jajmangold/emt-corexy/stl/TeeZCross_M.stl

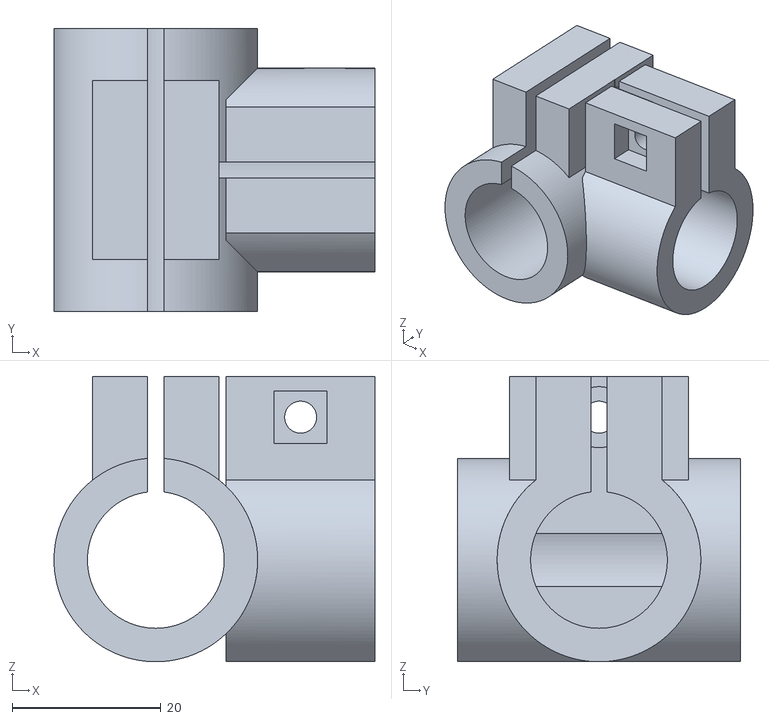
[picture p4: CAD file, 2026-11-10]
stl/TeeZCross_M.stl
43.2 x 38.0 x 38.4
