jajmangold/emt-corexy/stl/BedCarriage.stl

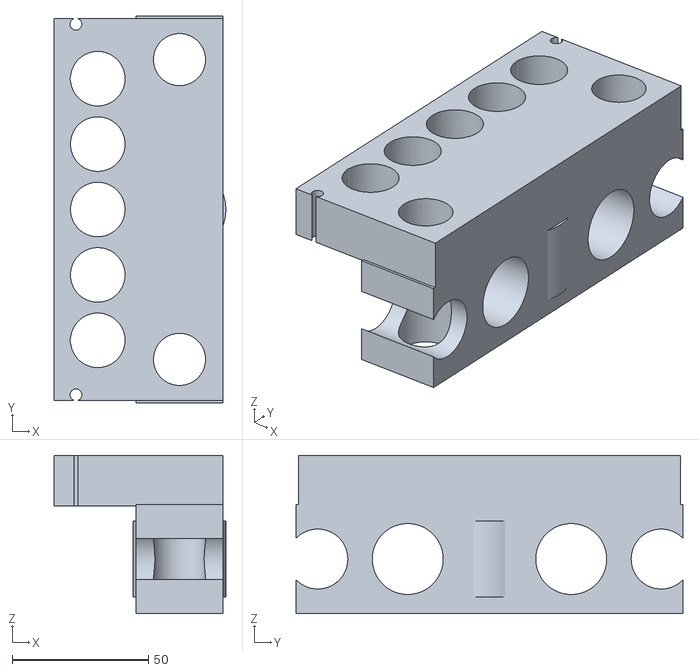
[picture p5: CAD file, 2026-11-10]
stl/BedCarriage.stl
63.0 x 142.0 x 58.0
