jajmangold/emt-corexy/stl/ZMotorMount_M.stl

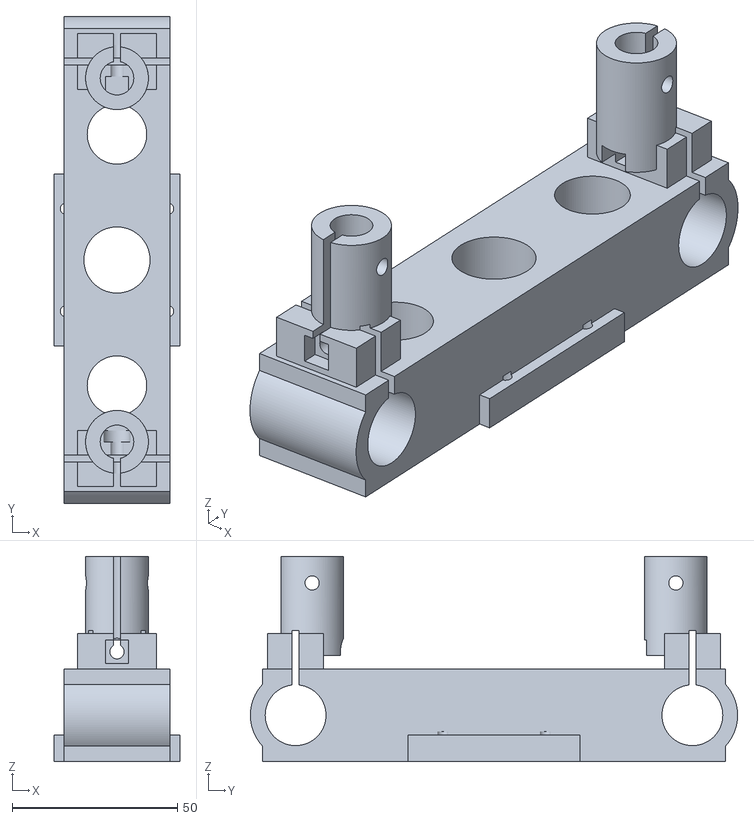
[picture p6: CAD file, 2026-11-10]
stl/ZMotorMount_M.stl
38.0 x 147.4 x 62.0
