jajmangold/emt-corexy/stl/BedMount.stl

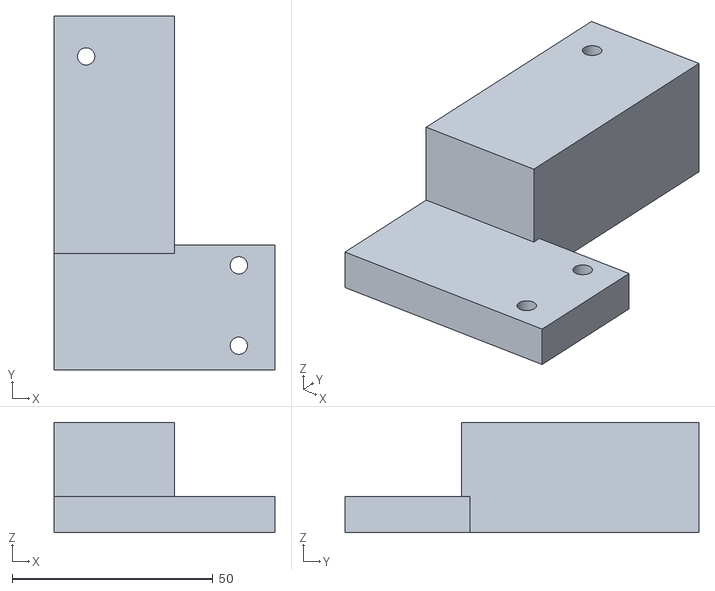
[picture p7: CAD file, 2026-11-10]
stl/BedMount.stl
55.0 x 88.0 x 27.5
