jajmangold/emt-corexy/stl/CornerTower_R.stl

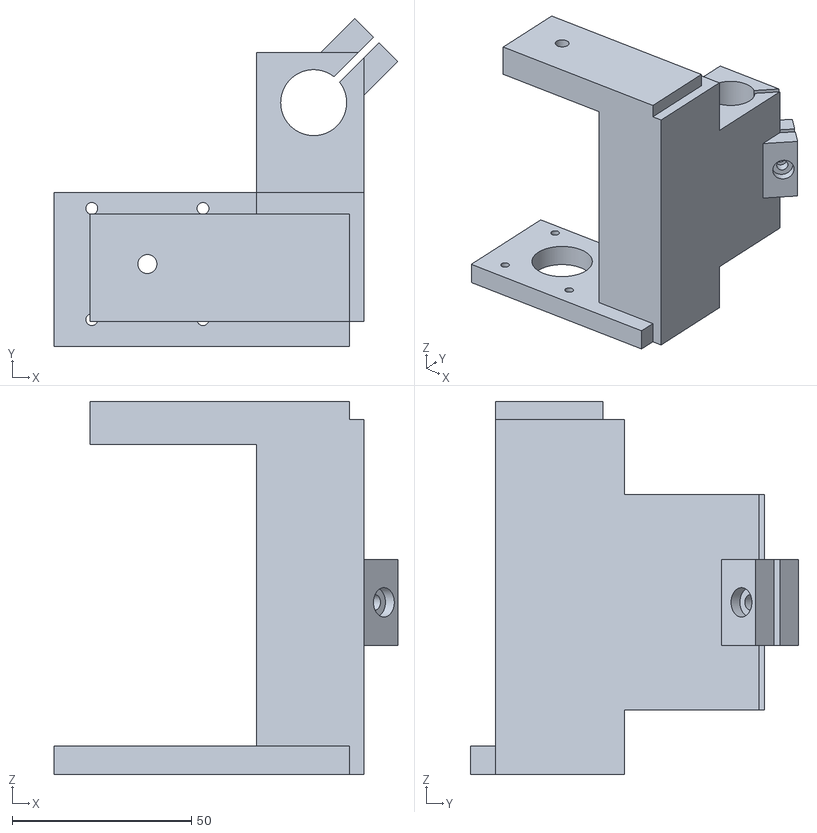
[picture p8: CAD file, 2026-11-10]
stl/CornerTower_R.stl
95.8 x 91.5 x 104.0
