jajmangold/emt-corexy/stl/XCarriage.stl

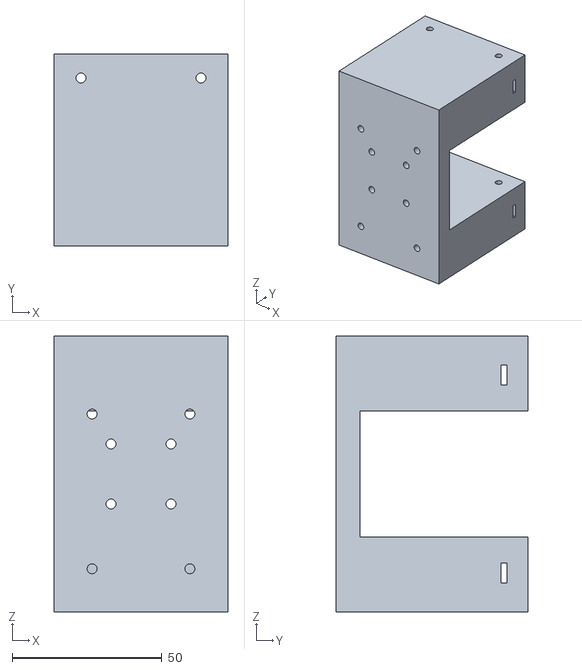
[picture p9: CAD file, 2026-11-10]
stl/XCarriage.stl
58.0 x 64.0 x 92.0
