jajmangold/emt-corexy/stl/Gusset_side_high_M.stl

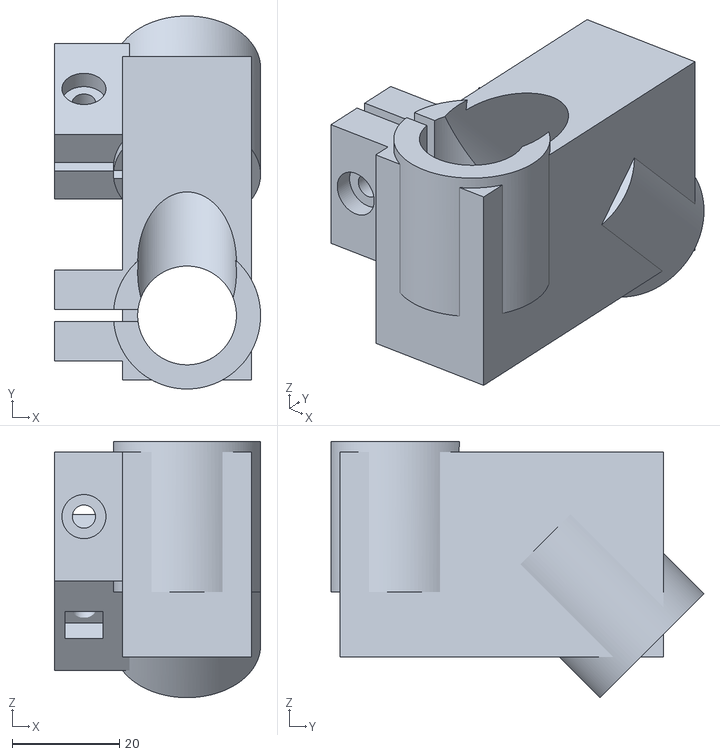
[picture p10: CAD file, 2026-11-10]
stl/Gusset_side_high_M.stl
38.4 x 69.4 x 47.7
