jajmangold/emt-corexy/stl/Joint4_corner.stl

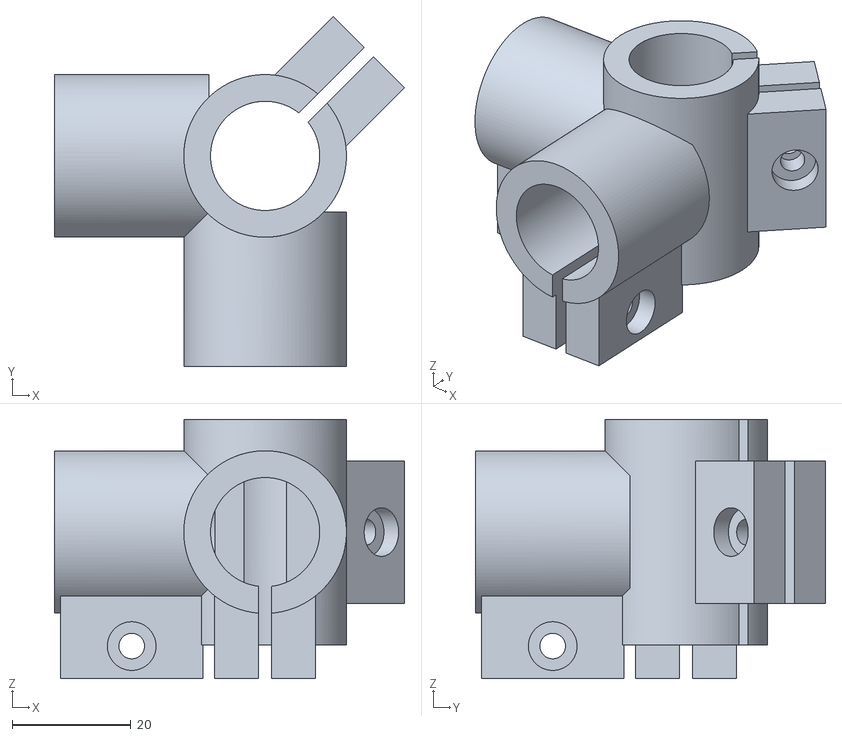
[picture p11: CAD file, 2026-11-10]
stl/Joint4_corner.stl
58.9 x 58.9 x 43.7
