jajmangold/emt-corexy/stl/YCarriage_M.stl

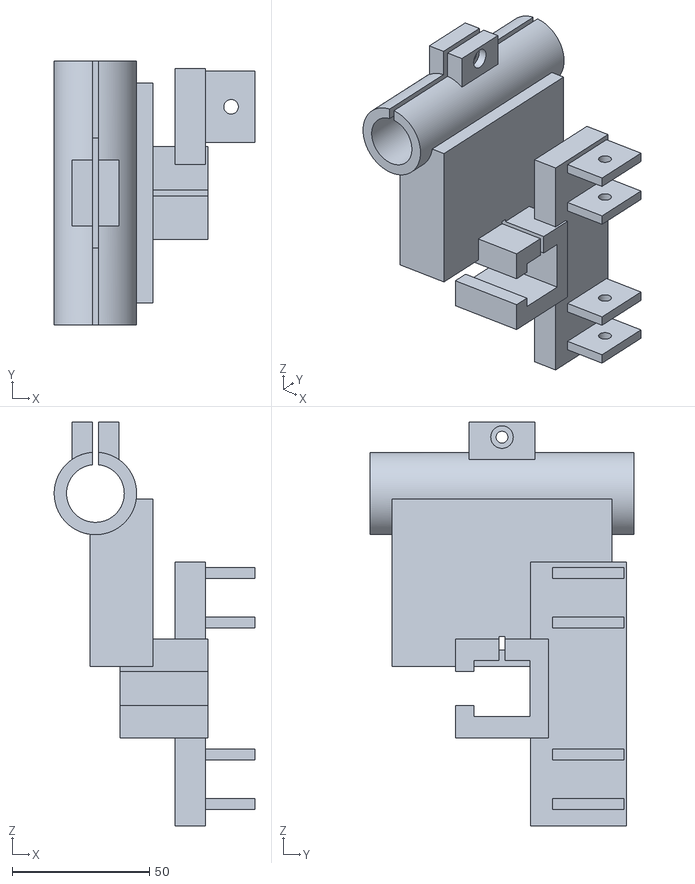
[picture p12: CAD file, 2026-11-10]
stl/YCarriage_M.stl
73.0 x 96.0 x 147.0
