jajmangold/emt-corexy/stl/WipeBracket.stl

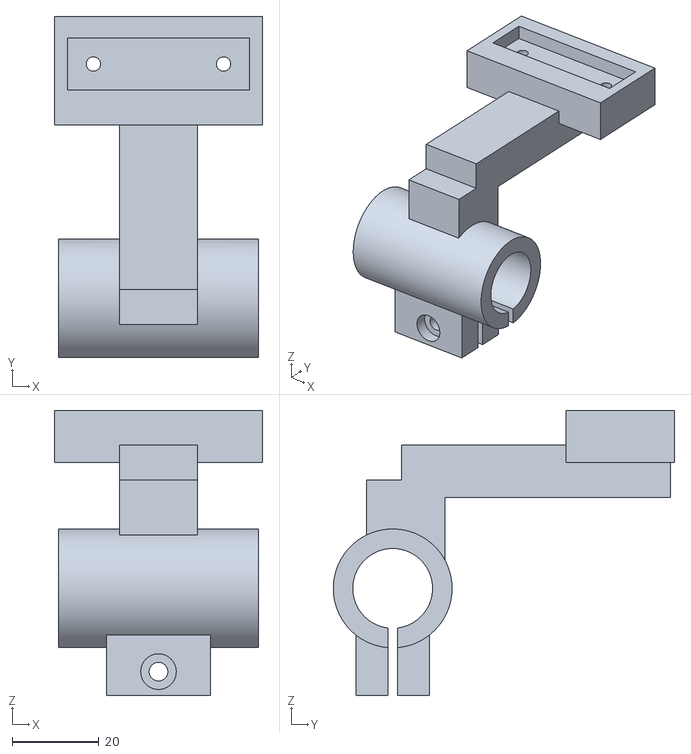
[picture p13: CAD file, 2026-11-10]
stl/WipeBracket.stl
48.0 x 78.7 x 65.7
