jajmangold/emt-corexy/stl/FootPad.stl

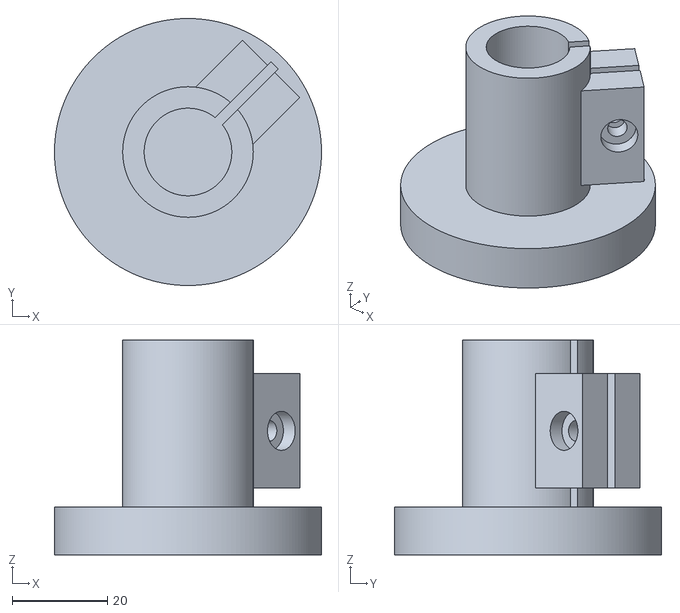
[picture p14: CAD file, 2026-11-10]
stl/FootPad.stl
56.0 x 56.0 x 45.0
