jajmangold/emt-corexy/stl/Gusset_rear_low.stl

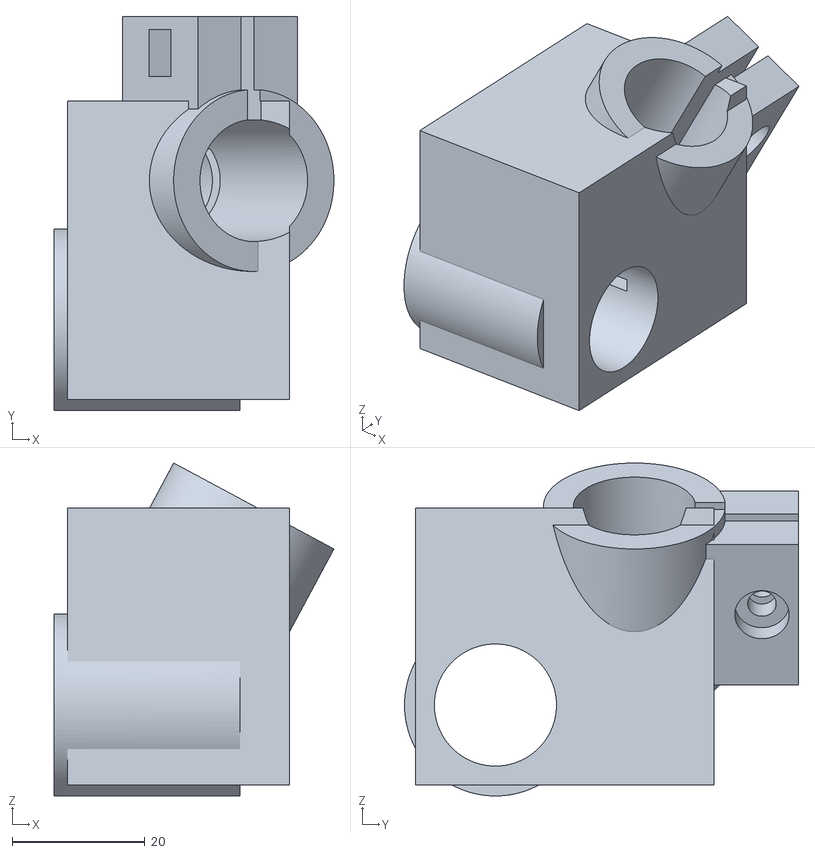
[picture p15: CAD file, 2026-11-10]
stl/Gusset_rear_low.stl
42.1 x 59.3 x 50.1
