jajmangold/emt-corexy/stl/Gusset_cap_a.stl

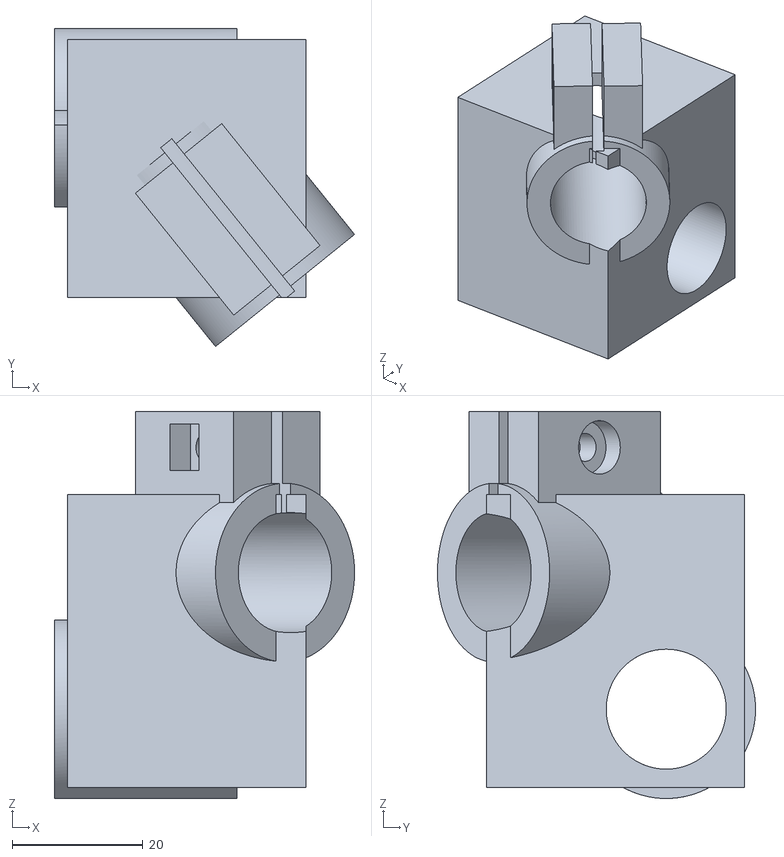
[picture p16: CAD file, 2026-11-10]
stl/Gusset_cap_a.stl
46.0 x 48.7 x 59.3
