jajmangold/emt-corexy/stl/YRodBlock_M.stl

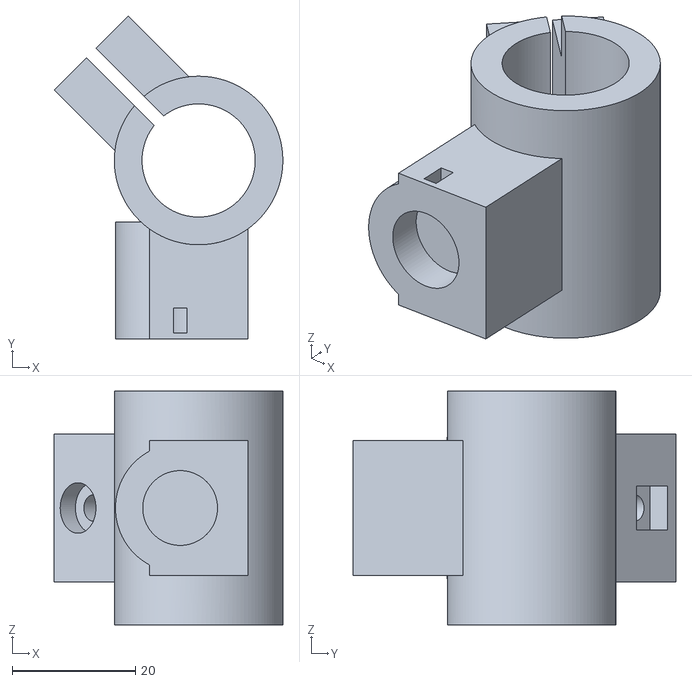
[picture p17: CAD file, 2026-11-10]
stl/YRodBlock_M.stl
37.2 x 52.5 x 38.0
