jajmangold/emt-corexy/stl/CornerTower_L_M.stl

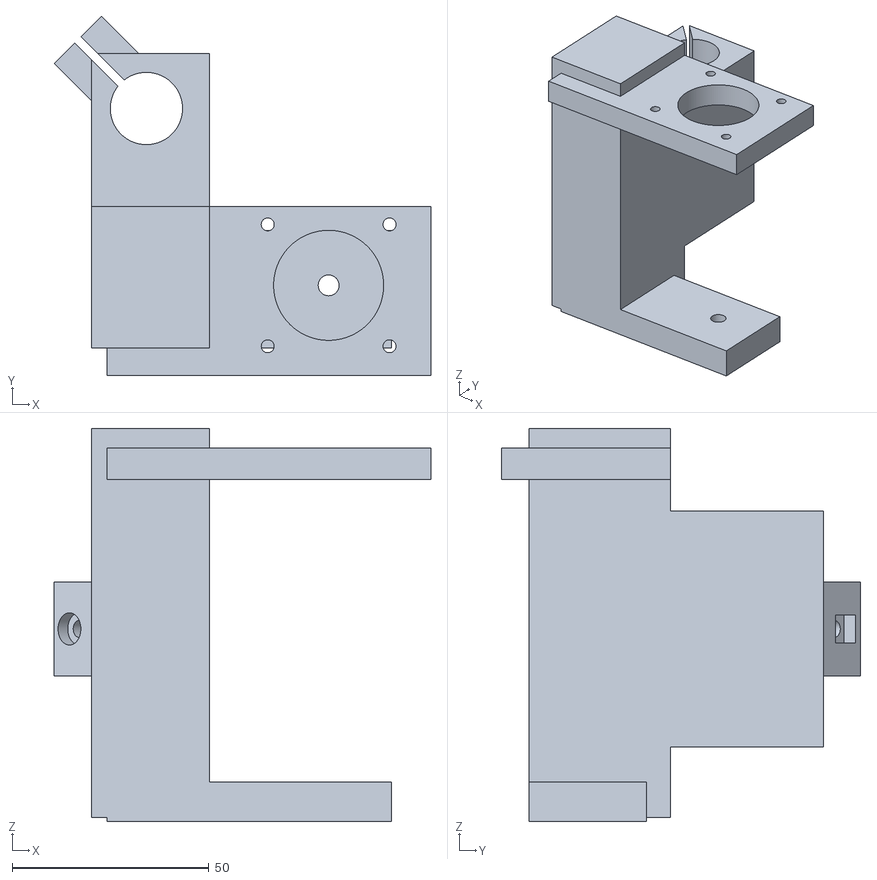
[picture p18: CAD file, 2026-11-10]
stl/CornerTower_L_M.stl
95.8 x 91.5 x 100.0
