jajmangold/emt-corexy/(list of files, cad)

Other CAD files:
stl/ZMotorMount.stl
stl/BedCarriage_M.stl
stl/BedMount_M.stl
stl/Gusset_side_low.stl
stl/YCarriage.stl
stl/Gusset_side_high.stl
stl/Gusset_rear_high.stl
stl/TeeZCross.stl
stl/YRodBlock.stl
stl/Gusset_side_low_M.stl
stl/Gusset_cap_b.stl
