jajmangold/emt-corexy/(commit log)

2026-11-10 EMT conduit CoreXY printer: parametric model, checks, STLs
    A 300 x 300 x 400 mm CoreXY whose frame is nothing but 1/2 inch EMT
    electrical conduit on printed pinch clamps. All motion on hardened rod
    and an MGN12 X axis; BTT SKR Pico; stock Voron Stealthburner toolhead.
    Everything is generated from params.py, which is the only place any
    dimension exists. build.py redraws the machine, runs four independent
    checks, exports 26 validated STLs and regenerates README.md and
    PRINT_LIST.md, and refuses to write anything if a check fails.
    Checks: 1-D parameter invariants; pose-sampled box overlap over 441
    machine poses; real boolean intersection of every candidate pair; and a
    positive assertion that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
    [BedCarriage.stl, BedCarriage_M.stl, BedMount.stl, BedMount_M.stl, CornerTower_L_M.stl, CornerTower_R.stl, FootPad.stl, Gusset_cap_a.stl]
2026-11-10 Illustrated assembly guide, animations, and a quantity check
    Adds ASSEMBLY.md: thirteen steps, each rendered from the model with the
    part going on now in orange and what is already built in grey, plus
    close-ups for the steps whose parts are too small to see at whole-machine
    scale. Three animations in the README: a turntable, the CoreXY motion,
    and an exploded view in which the conduit stays put so the frame reads as
    the skeleton everything else locates against.
    render.py and make_media.py drive the FreeCAD GUI viewer; steps.py holds
    the sequence so the headless generator can read it without a GUI.
    Fixes a real error this surfaced: the print list asked for 18
    Joint4_corner and the model pla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
2026-11-10 Fix diagonal lengths in the assembly steps; reconcile against the lists
    The per-step conduit tables measured the longest AXIS of each piece's
    bounding box. For the five diagonals that is not their length: the rear
    brace read 698 mm instead of 783, the side braces 519 instead of 715 and
    the cap braces 166 instead of 199. Anyone cutting from the assembly steps
    rather than the cut list would have cut five pieces too short.
    Lengths now come from the piece's own axis - project its vertices onto
    the lateral cylindrical face's axis - and every piece is labelled with
    what it is rather than just a number.
    build.py gains a coverage check: the per-step tables must total to the
    cut list and the print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
